KevinWahle/E3-Alarma-Para-Hogar/ORGANIGRAMA_E3.pdf

# TP2 - E3

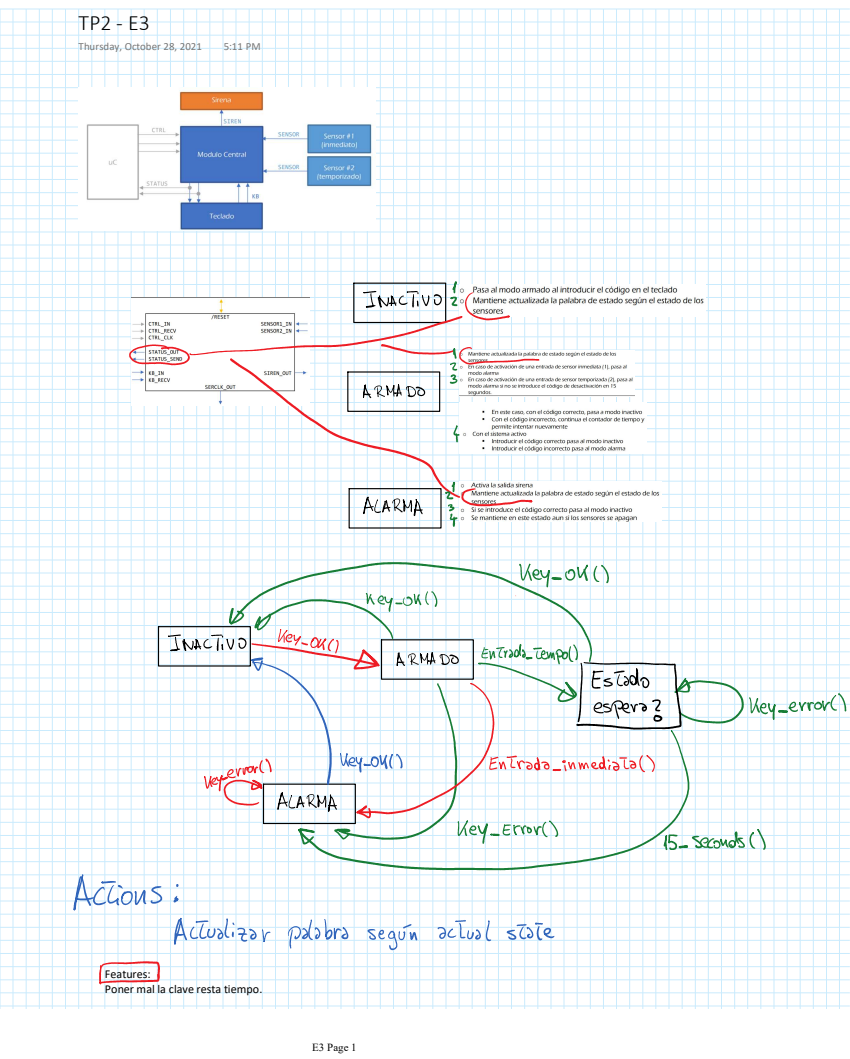
[picture p9: page 1]
Thursday, October 28, 2021; E3 Page 1

Features:
Poner mal la clave resta tiempo.

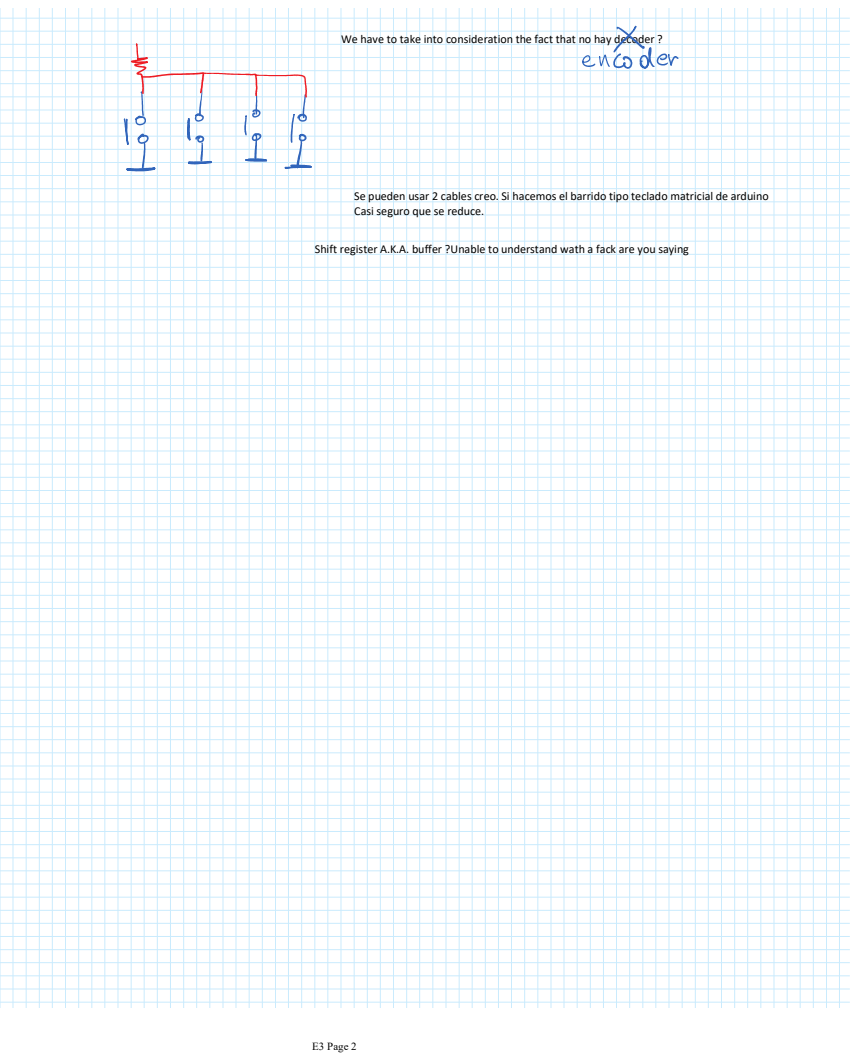
[picture p10: page 2]
E3 Page 2

We have to take into consideration the fact that no hay decoder ?

Se pueden usar 2 cables creo. Si hacemos el barrido tipo teclado matricial de arduino
Casi seguro que se reduce.

Shift register A.K.A. buffer ?Unable to understand wath a fack are you saying
