KevinWahle/E3-Alarma-Para-Hogar/MainModule/compile.cfg

[View]
Entity=Test
Architecture=
TopLevelType=3
[file:.\src\MainModule.v]
Enabled=1
[file:.\src\timer.v]
Enabled=1
[file:.\src\serialOut.v]
Enabled=1
[file:.\src\serialIn.v]
Enabled=1
[file:.\..\..\..\..\3-Electro3\TPs\TP2\MainModule\src\simulation.awc]
Enabled=1
[file:.\src\CodeChecker.v]
Enabled=1
[file:.\src\easySerialOut.v]
Enabled=1
[file:.\src\MainTestBench.v]
Enabled=1
[file:.\..\..\..\..\Electronica3\TP2\TP2-G2_E3\MainModule\src\MainTestWF.asdb]
Enabled=1
[file:.\..\..\..\..\Electronica3\TP2\TP2-G2_E3\MainModule\src\MainTestWF.awc]
Enabled=1
[file:.\src\testEasySerialOut.v]
Enabled=1
[file:.\src\testTimer.v]
Enabled=1
