KevinWahle/E3-Alarma-Para-Hogar/MainModule/src/TestBench.v

module Test;
	reg SIREN_OUT_;   //Salida de sirena
    reg SENSOR1_IN_, SENSOR2_IN_;  //Sensores

    wire STATUS_OUT_; //Datos
    wire STATUS_SEND_; //Habilitador
    reg KB_IN_;   //Datos
    reg KB_RECV_;   //Habilitador 

    wire CTRL_IN_, CTRL_RECV_, CTRL_CLK_;
	
	wire SERCLK_OUT_;
	reg RESET_OUT_; 	
	
	MainModule alarmante (
	.SIREN_OUT(SIREN_OUT_), .SENSOR1_IN(SENSOR1_IN_), .SENSOR2_IN(SENSOR2_IN_),
	.STATUS_OUT(STATUS_OUT_), .STATUS_SEND(STATUS_SEND_),
	.KB_IN(KB_IN_), .KB_RECV(KB_RECV_),
	.CTRL_IN(CTRL_IN_), .CTRL_RECV(CTRL_RECV_), .CTRL_CLK(CTRL_CLK_),
	.SERCLK_OUT(SERCLK_OUT_), .RESET_OUT(RESET_OUT_)  
	);
	
	
initial begin
	#10ns SENSOR1_IN_ = 0;
	#10ns SENSOR2_IN_ = 0;
	#10ns KB_RECV_ = 1;
	#50ns KB_RECV_ = 0;
	#50ns SENSOR1_IN_ = 1;
	#400ns $finish;	
	
end
endmodule
