KevinWahle/E3-Alarma-Para-Hogar/(commit log)

2021-11-07 Inicio de easySerialOut
2021-11-07 CodeChecker agregado
    Módulo que verifica si el código enviado desde el teclado es correcto o no
    [CodeChecker.v]
2021-11-07 Modulos implementados y testeados en maq de estado
2021-11-07 Archivos de simulacion de Aldec
    [compile.cfg]
2021-11-08 Creado implementacion en Radiant Falta solucionar problemas de compatibilidad
    [CodeChecker.v, MainModule.v, MainTestBench.v]
2021-11-15 no errors, but not tested
    [ModuloAlarmaTP2_impl_1_vo.sdf]
2021-11-17 Mejoras de warnings No detecta KB
    [ModuloAlarmaTP2_impl_1_vo.sdf]
2021-11-18 Pruebas en FPGA
    [ModuloAlarmaTP2_impl_1_vo.sdf]
2021-11-18 Mas avances en FPGA y Debug
    [ModuloAlarmaTP2_impl_1_vo.sdf]
2021-11-18 added aldec to test
    [compile.cfg, library.cfg, projlib.cfg]
2021-11-18 Mas DEBUG
    [ModuloAlarmaTP2_impl_1_vo.sdf]
2021-11-18 Dale que arrancamos
2021-11-18 Timer & SerialOut works well
2021-11-18 final stage
    [ModuloAlarmaTP2_impl_1_vo.sdf]
2021-11-18 bien
    some times maybe good somes times meybe shit
    [ModuloAlarmaTP2_impl_1_vo.sdf]
2021-11-18 much better
    [ModuloAlarmaTP2_impl_1_vo.sdf]
2021-11-18 otra mas
    [ModuloAlarmaTP2_impl_1_vo.sdf]
2021-11-18 all good
    [ModuloAlarmaTP2_impl_1_vo.sdf]
2021-11-18 DONE
    FUNCIONA TODO
    [ModuloAlarmaTP2_impl_1_vo.sdf]
2021-11-19 minor fixes
    [compile.cfg]
